tesanoff/midibayan/(threads)

Thread 1 (2024-10-23):

Работа отдельных фрагментов кода

Alexandr010360, 2024-10-23:
Здравствуйте Александр! Меня очень заинтересовал ваш проект! Особенно структура кода! Всё упорядочено, по полочкам и системно! Хотел позаимствовать у вас управление клавиатурой через сдвиговые регистры 74HC165. Даже сделал макет фрагмента кода из трёх кнопок. Но к сожалению он не заработал. Вы не смогли бы набросать мне фрагмент кода касающийся клавиатуры, который бы работал автономно и передавал миди команды.

tesanoff, 2024-10-23:
Добрый день.
к 6-й ноге ардуинки подключен каскад, читающий левую клавиатуру. [здесь задан этот пин](https://github.com/tesanoff/midibayan/blob/211e6babf87a316b51ede85d33aca2efe7c3e462/tes_midi_bayan/TesKeyboard.cpp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)

Смотрите как читается левая клавиатура.

В интернете очень много информации о том, как читать данные из сдвиговых регистров. (Если проблема именно с чтением данных из регистров). Соберите простейшую схему на макетке и тренируйтесь, как я делал: https://tesanoff.klah.ru/?p=5414

Alexandr010360, 2024-10-23:
Благодарю Александр! Теперь увидел замок! Буду пробовать! А что касается простейшего макета работы с регистрами то у меня это всё работает.

tesanoff, 2024-10-23:
Класс TesKeyboard читает данные с регистров, смотрит какие "музыкальные" кнопки были нажаты (или отпущены) и на основании этой информации помещает во внутреннюю очередь сообщений сообщения о соответствующих событиях. Только этот класс знает, что есть 2 каскада регистров, и т.д.

Класс TesMIDIController получает эти сообщения из внутренней очереди и обрабатывает (посылает соответствующие миди команды.) Миди-контроллер не знает ничего о деталях реализации чтения клавиатуры.

Alexandr010360, 2024-10-23:
На портe Ардуино D6 указан сигнал Kbd-DATA2 и есть разъём J6. Но на остальных схемах я не нащёл этого сигнала замка! Откуда он поступает?

Alexandr010360, 2024-10-23:
На схеме левой клавиатуры есть разъём J1 и на нём сигнал data-out. Это он?

tesanoff, 2024-10-23:
> На схеме левой клавиатуры есть разъём J1 и на нём сигнал data-out. Это он?

Так точно

tesanoff, 2024-10-23:
И ещё момент: эта прошивка не заработает нормально, если не подключен экранчик. Зависнет на этапе инициализации экранчика.

Alexandr010360, 2024-10-25:
Тема закрыта!

Alexandr010360, 2024-10-27:
Собрал макет из двух регистров сдвига и шести кнопок! Подаю питание, инициализация проходит нормально! Импульсы Latch и CLK присутствуют! Но только соит нажать одну из шести кнопок проскакивает один импульс Kbd-DATA и ардуинка намертво зависает! Latch и CLK пропадают! Сбрасываю её кнопкой сброса на плате и повторяется тоже самое! Отключаю от ардуинки входы Kbd-DATA  и она начинает работать нормально! Kbd-DATA на 9 ножках регистров при нажатии любой из кнопок имеются! Но стоит их подсоединить к ардуинке то она перестаёт работать!

Alexandr010360, 2024-10-27:
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

Alexandr010360, 2024-10-27:
Фто макета прилагаю...

tesanoff, 2024-10-27:
Извините, я с вашей бедой вам помочь не могу.
Могу только пожелать успехов в поиске причины такого поведения вашего макета.

Alexandr010360, 2024-10-27:
Спасибо Александр! Уже разобрался! Я брал по одному регистру на левую и правую клавиатуру! В этом случае сигнал переноса на 10 выводе регистра должен быть притянут к питанию! А я этого не сделал! А при каскадном включении нескольких регистров сигнал переноса приходит с предыдущего регистра!

Alexandr010360, 2024-10-27:
Uploading WhatsApp Video 2024-10-27 at 19.11.52.mp4…

Alexandr010360, 2024-10-27:
Uploading WhatsApp Video 2024-10-27 at 19.11.52.mp4…

Alexandr010360, 2024-10-27:
https://github.com/user-attachments/assets/d49b1244-3ceb-4390-b175-83d8c6913b7b

Alexandr010360, 2024-10-27:
Вот результат! Тему закрываю!

tesanoff, 2024-10-27:
Ишь ты.
Даже какие-то звуки издаёт. :)

Alexandr010360, 2024-10-27:
Это у меня работает через виртуальный мост Hairless MIDI<->Serial Bridge! А с него уже идёт на программный секвенсор...

tesanoff, 2024-10-28:
Кстати, я обратил внимание, что есть очень заметная задержка между щелчком кнопки и звуком инструмента.

Видимо это из-за не самого быстродействующего софта.

Я подключался к VMPK (на Линуксе) https://sourceforge.net/projects/vmpk/
Вообще никаких задержек не слышно.

tesanoff, 2024-10-28:
Адаптация для гармони делается здесь: https://gitflic.ru/project/tesanoff/midi-garmon
Еще не готово.
Точнее говоря, схемы уже нарисованы, платы заказаны и едут к хозяину гармони. Проверки на реальном железе пока не было. Когда будет готово - сделаю релиз на Gitflic и возможно сделаю зеркало на github.

Alexandr010360, 2024-10-28:
Благодарю за ваш огромный труд! Пытался сам адаптировать прошивку под гармонь! Но как говорят чужая прошивка для меня пока тёмный лес! Долго нужно изучать что к чему!

Alexandr010360, 2024-10-28:
Я тоже сейчас скачал и подключал  VMPK. Задержка стала меньше! Дело в драйвере звуковой карты. Тем более подключение не через миди кабель а по UART. Для опытов нормально. А потом можно подключиться по стандартному протоколу через миди кабель к внешней звуковой карте. Там задержки вообще незаметны на слух!

tesanoff, 2024-10-28:
Да, в windows не самая быстрая MIDI поддержка...

Alexandr010360, 2024-10-29:
Добрый день Александр! Читал ваш блог и планы на будущее! Желаю вам успеха! Планы поистине грандиозные! Идея с SD-картой мне понравилась! Вот бы можно было с карты проигрывать стили автоаккомпанимента а не только жёстко запрограммированный ритм! Так же можно было бы гибко менять и конфигурацию оборудования. Назначать функции клавиш и кнопок управления. Назначать горячие клавиши чтобы менять на ходу во время исполнения песни разные эффекты, тембры, стили автоаккомпанимента! У меня есть исходники по этой теме. Могу поделиться! Зачем велосипед изобретать заново, когда его уже изобрели... Куда вам отправить файлы?

Alexandr010360, 2024-10-29:
`/*
    BLE_MIDI_HARMONICA
*/

#include <BLEDevice.h>
#include <BLEUtils.h>
#include <BLEServer.h>
#include <BLE2902.h>
#include "notes.h"
#include "keyboards.h"

#define CHANNEL0 0
#define CHANNEL1 1
#define CHANNEL2 2

#define SERVICE_UUID        "03b80e5a-ede8-4b33-a751-6ce34ec4c700"
#define CHARACTERISTIC_UUID "7772e5db-3868-4112-a1a9-f2669d106bf3"

const byte LATCH = 25;
const byte DATA  = 26;
const byte CLOCK = 14;

BLECharacteristic *pCharacteristic;
bool deviceConnected = false;

class MyServerCallbacks: public BLEServerCallbacks {
    void onConnect(BLEServer* pServer) {
      deviceConnected = true;
    };

    void onDisconnect(BLEServer* pServer) {
      deviceConnected = false;
    }
};

void setupBle() {
  BLEDevice::init("MIDI HARMONICA");
  BLEServer *pServer = BLEDevice::createServer();
  pServer->setCallbacks(new MyServerCallbacks());
  BLEService *pService = pServer->createService(BLEUUID(SERVICE_UUID));
  pCharacteristic = pService->createCharacteristic(
                      BLEUUID(CHARACTERISTIC_UUID),
                      BLECharacteristic::PROPERTY_READ   |
                      BLECharacteristic::PROPERTY_WRITE  |
                      BLECharacteristic::PROPERTY_NOTIFY |
                      BLECharacteristic::PROPERTY_WRITE_NR
                    );
  pCharacteristic->addDescriptor(new BLE2902());
  pService->start();
  BLEAdvertising *pAdvertising = pServer->getAdvertising();
  pAdvertising->addServiceUUID(pService->getUUID());
  pAdvertising->start();
}

void setupKeyboard() {
  pinMode(LATCH, OUTPUT);
  pinMode(CLOCK, OUTPUT);
  pinMode(DATA, INPUT);
  digitalWrite(LATCH, HIGH);
}

uint64_t readKeyboard() {
  digitalWrite(LATCH, LOW);
  digitalWrite(LATCH, HIGH);

  byte buffer[8];
  for ( int i = 0; i < 8; i++) {
    buffer[i] = shiftIn(DATA, CLOCK, MSBFIRST);
  }

  uint64_t states = 0;
  for ( int i = 7; i >= 0; i--) {
    states <<= 8;
    states |= (uint64_t) buffer[i];
  }
  return states;
}

void noteOn(BLECharacteristic *midiDevice, uint8_t note, uint8_t channel) {
  uint8_t channels[3] = { 0x90, 0x91, 0x92 };
  uint8_t midiPacket[] = {
    0x80,               // header
    0x80,               // timestamp, not implemented
    channels[channel],  // action
    note,               // pitch
    127                 // velocity
  };
  midiPacket[2] = channels[channel];    // note down, channel 0
  midiPacket[3] = note;                 // note
  midiPacket[4] = 127;                  // velocity
  midiDevice->setValue(midiPacket, 5);  // packet, length in bytes
  midiDevice->notify();
}

void noteOff(BLECharacteristic *midiDevice, uint8_t note, uint8_t channel) {
  uint8_t channels[3] = { 0x80, 0x81, 0x82 };
  uint8_t midiPacket[] = {
    0x80,               // header
    0x80,               // timestamp, not implemented
    channels[channel],  // action
    note,               // pitch
    0                   // velocity
  };
  midiDevice->setValue(midiPacket, 5);  // packet, length in bytes
  midiDevice->notify();
}

void processKeyboardChanges(uint64_t keyboard) {
  static uint64_t last_keyboard = 0;
  if (keyboard == last_keyboard) {
    return;
  }
  uint64_t changed = keyboard ^ last_keyboard;
  last_keyboard = keyboard;
  for (int i = 0; i <= 64; ++i)
  {
    if (changed & 1) {
      handleChange(i, keyboard & 1);
    }
    changed >>= 1;
    keyboard >>= 1;
  }
}

void handleChange(int key, int state) {
  uint8_t note = 0;
  uint8_t channel = 0;
  if (key < sizeof(rightKeyboard)) {
    note = rightKeyboard[key];
    channel = CHANNEL0;
  } else if (key >= 32 && key < (32 + sizeof(bassKeyboard))) {
    note = bassKeyboard[key - 32];
    channel = CHANNEL1;
  } else if (key >= 32 + sizeof(bassKeyboard)) {
    note = accordKeyboard[key - 32 - sizeof(bassKeyboard)];
    channel = CHANNEL2;
  } else {
    return;
  }
  if (state) {
    Serial.print("noteOn -> ");
    Serial.println(note);
    Serial.print("channel -> ");
    Serial.println(channel);
    Serial.println("");
    noteOn(pCharacteristic, note, channel);
  } else {
    Serial.print("noteOff -> ");
    Serial.println(note);
    Serial.print("channel -> ");
    Serial.println(channel);
    Serial.println("");
    noteOff(pCharacteristic, note, channel);
  }
}

void setup() {
  Serial.begin(115200);
  setupKeyboard();
  setupBle();
}

void loop() {
  if (deviceConnected) {
    uint64_t keyboard = readKeyboard();
    processKeyboardChanges(keyboard);
  }
}
`

tesanoff, 2024-10-29:
>  У меня есть исходники по этой теме. Могу поделиться!

спасибо, ничего не надо :)

Alexandr010360, 2024-10-29:
Всё понял! Извините!

tesanoff, 2024-10-29:
не за что извиняться, что вы.

Просто я в чужой код стараюсь вообще не лазить, если нет острой необходимости. Применительно к чтению миди-файлов такая необходимость есть (писать своё будет заметно дольше, чем адаптировать чужое), но я уже нашёл шикарный исходник. (см блог)

Alexandr010360, 2024-10-29:
Хотел бы иногда по возможности обращаться к вам за помощью в некоторых критических ситуациях! Дело в том что я уже два года использую миди библиотеку адаптированную в универсальную панель управления DAW. Эта библиотека имеет возможность расширения и добавление в неё новых функций! Но к сожалению автором уже не поддерживается! Я её переделал под свои нужды и сделал миди гармонь Беларусь. Но там есть не решёные ньюансы. Один из них это отстсутствие поддержки регистров сдвига! Пришлось всё делать на матрицах. И второй ньюанс это отображение на дисплее не названий программ, а их номеров в миди системе, как и в вашем коде! Ну это ладно, как то можно смириться! Но вот во второй версии моей гармони, предназначеной к совместной работе с DAW vAranger это недопустимо! В этом проекте кнопки панели управления программно привязаны к параметрам DAW. И я должен видеть полное отображение на дисплее этих параметров, когда я нажимаю одну из кнопок панели управления! А их 30 штук! Цифры тут никак не уместны! А параметры настроек и управление DAW вот они: 1 TRANSPOSE -
  2 TRANSPOSE +
  3 PREV S0NG
  4 NEXT SONG
  5 TEMPO -
  6 TEMPO +
  7 MANUAL BASS
  8 BASS TO LOWEST
  9 SECUND BOICE
  10 FULL KEYBOARD
  11 MY S0UND RIGHT 1
  12 MY S0UND RIGHT 2
  13 MY S0UND RIGHT 3
  14 MY S0UND RIGHT 4
  15 MY S0UND RIGHT 5
  16 MY SOUND LEFT 1
  17 MY SOUND LEFT 2
  18 MY SOUND LEFT 3
  19 MY SOUND LEFT 4
  20 MY SOUND LEFT 5
  21 START/STOP
  22 SYNG START
  23 INTRO 1
  24 INTRO 2
  25 INTRO 3
  26 ENDING 1
  27 ENDING 2
  28 ENDING 3
  29 VARIATION DOWN
  30 VARIATION UP

tesanoff, 2024-10-29:
а в чем сам вопрос?

Alexandr010360, 2024-10-29:
Матрицы заменить на регистры сдвига и параметры кнопок управления отобразить на дисплее! Вот и ломаю голову как это сделать...

Alexandr010360, 2024-10-29:
Это нужно ворошить библиотеку или просто в код добавить коассы дисплея и регистров сдвига...

Alexandr010360, 2024-10-29:
Знаний в программировании недостаточно...

tesanoff, 2024-10-29:
> Матрицы заменить на регистры сдвига

Если честно, не понял.

"Регистр сдвига" - это микросхемы которые, например, я использовал для ввода кнопок и вывода на светодиоды 74HC165 и 74HC595.
А "матрица" - это что?

Alexandr010360, 2024-10-29:
Матричная клавиатура как на первом баяне Александра Поликарпова...

tesanoff, 2024-10-29:
а-а-а. Понял.
Замену этой системы ввода на ввод через регистры я уже сделал. :)

Читайте здесь: https://github.com/tesanoff/midibayan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

Alexandr010360, 2024-10-29:
Так вот по этой причине меня и заинтересовал ваш собственный проект! А вот как это прикрутить к моему коду пока ломаю голову!

Alexandr010360, 2024-10-29:
Для проекта гармони все порты Ардуино Мега почти заняты! А для баяна вообще уже не хватает портов! Применение в моём проекте регистров сдвига решило бы проблему...

Alexandr010360, 2024-10-29:
Сделать какой нибудь отдельный класс с регистрами сдвига и прилепить его к моему коду! Пока не знаю как это сделать!

tesanoff, 2024-10-29:
Ну, берите мою прошивку и дорабатывайте под свои нужды. Я никаких ограничений на эту тему не накладываю.

Возможно, вам стоит взять в соавторы программиста, квалификации которого будет достаточно, чтобы разобраться в коде и придумать, что и как надо менять. (Я не возьмусь, если что).

Alexandr010360, 2024-10-29:
Вот я и изучаю вашу прошивку! Так то конечно разберусь и без программистов только это будет долгий процесс...
Буду следить за вашими новыми публикациями! Очень интересные у вас идеи! Бутусову и не снились такие идеи со стилями для автоаккомпанимента!

Alexandr010360, 2024-10-30:
Как сделать чтобы нажатие одной из множества кнопок на дисплее отображалось её название одной строчкой? В интернете что то не нашёл такой пример кода...

tesanoff, 2024-10-30:
Если по-нормальному, то надо добавлять ещё один вариант экрана:
* идентификатор статуса экрана
* функция для отрисовки экрана
* функция для обработки нажатий клавиш в этом режиме
* посмотреть не возникает ли нежелательных побочных эффектов

Если для отладки, то:
* чистим экран вызывая функцию clear() если правильно помню
* печатаем на экране всё что надо
* выводим буфера на экран функцией update()
* Даём задержку на пару-тройку секунд, чтобы успеть это прочитать

Alexandr010360, 2024-10-30:
Спасибо Александр за инструкцию! Буду пробовать...

Closed 2024-10-27.

Thread 2 (2024-10-24):

Смена дисплея на SSD1306_128x64

Alexandr010360, 2024-10-24:
Добрый день Александр! У меня в наличии дисплей SSD1306_128x64. В скетче меняю SSH1106_128x64 на SSD1306_128x64! Но компилятор начинает ругаться! Помогите пожалуйста разобраться в проблеме...

Alexandr010360, 2024-10-24:
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

Alexandr010360, 2024-10-24:
Вот такие крякозябры с моим дисплеем!

tesanoff, 2024-10-24:
Документацию на библиотеку изучали? https://github.com/GyverLibs/GyverOLED
(Особенно разделы "Инициализация" и "Использование")

Работу примеров (https://github.com/GyverLibs/GyverOLED/tree/main/examples) на вашем экране проверяли?

Alexandr010360, 2024-10-24:
Примеры все работают нормально! Использовал эту библиотеку в других своих проектах. Там всё отлично работает.

Alexandr010360, 2024-10-24:
Ядро я не менял. Может быть в этом дело? И вообще с кнопками работает очень не стабильно. С холлами не пробовал.

Alexandr010360, 2024-10-24:
Попробую сейчас ядро поменять...

tesanoff, 2024-10-24:
Проверяйте, во всех ли местах используется правильная инициализация класса дисплея.
В прошивке несколько таких мест.
Используйте команду "grep GyverOLED *"

tesanoff, 2024-10-24:
> И вообще с кнопками работает очень не стабильно.

Если это макетка, то:
1) контакты
2) висящие в воздухе входы регистров

Alexandr010360, 2024-10-24:
Все места посмотрел! И менял на другой дисплей. свободные входы регистров заземлил...

Alexandr010360, 2024-10-24:
А у вас нет такой возможности проверить с другим дисплеем ваш код?

Alexandr010360, 2024-10-24:
Придётся тогда купить дисплей SSH1106_128x64...

tesanoff, 2024-10-24:
Ну, чудес не бывает.
Ищите разницу между тем, что сейчас в прошивке, и тем, что в работающих примерах.
Покажите пример того, как вы инициализируете класс. Прям кусок вашего кода.

Alexandr010360, 2024-10-24:
Там не кусок кода. Я загрузил полностью вашу прошивку...

tesanoff, 2024-10-24:
> Там не кусок кода. Я загрузил полностью вашу прошивку...

Тип дисплея не меняли? Неудивительно что не работает.

Если меняли, то покажите измененный участок кода :)

Alexandr010360, 2024-10-24:
GyverOLED<SSH1106_128x64> oled; Все эти места менял...

Alexandr010360, 2024-10-24:
Может текст ошибки вам отправить?

Alexandr010360, 2024-10-24:
GyverOLED<SSD1306_128x64, OLED_NO_BUFFER> oled; Если только ещё так попробовать?

Alexandr010360, 2024-10-24:
В примерах если раскомментировать вот это GyverOLED<SSH1106_128x64> oled; То так же вылезают крякозябры как и в вашей прошивке...

tesanoff, 2024-10-24:
> GyverOLED<SSH1106_128x64> oled; Все эти места менял...

именно такие места надо было менять.
Покажите ваш вариант кода который получился после того, как вы поменяли тип дисплея.

Alexandr010360, 2024-10-24:
А если раскомментировать вот это GyverOLED<SSD1306_128x64, OLED_NO_BUFFER> oled; То дисплей работает нормально...

Alexandr010360, 2024-10-24:
Дело в том что в библиотеке и настраивать то нечего! А делаю как в примерах не работает!

Alexandr010360, 2024-10-24:
Я имею ввиду с вашим кодом...

Alexandr010360, 2024-10-24:
Не получается самому разобраться в вашей прошивке! Это автор только может...

Alexandr010360, 2024-10-24:
Буду дальше изучать код! Может что ещё увижу...

Alexandr010360, 2024-10-24:
Может ядро как то влияет?

Alexandr010360, 2024-10-24:
Да ладно! На Озоне есть такие дисплеи как ваш. Закажу и вопрос закрыт...

tesanoff, 2024-10-24:
> А если раскомментировать вот это GyverOLED<SSD1306_128x64, OLED_NO_BUFFER> oled; То дисплей работает нормально...

Так всё-таки работает дисплей или не работает?

В любом случае мне надо видеть код с вашим вариантом инициализации дисплея. Я не могу вслепую комментировать.
Пожалуйста, покажите тот код инициализации дисплея, который у вас сейчас.
И скажите, работает дисплей с таким вариантом инициализации или нет.

Жду кода.

Alexandr010360, 2024-10-24:
В примерах библиотеки работает а в вашем коде нет. Буду искать в чём причина...

Alexandr010360, 2024-10-24:
Собственно код ваш без изменения! Менял только это во всех файлах кода где он есть GyverOLED<SSD1306_128x64, OLED_NO_BUFFER> oled;

tesanoff, 2024-10-24:
> Собственно код ваш без изменения! Менял только это во всех файлах кода где он есть GyverOLED<SSD1306_128x64, OLED_NO_BUFFER> oled;

И в результате заработало или нет?

(Вообще, лучше выбрать вариант с буфером.)

Alexandr010360, 2024-10-24:
// OLED-дисплей
GyverOLED<SSD1306_128x64, OLED_NO_BUFFER> oled;

// MIDI-контроллер
TesMIDIController   theMIDIController(&ledSet, &oled); - ругается на это!

tesanoff, 2024-10-24:
> TesMIDIController theMIDIController(&ledSet, &oled); - ругается на это!

Правильно, потому что менять нужно везде, где встречается строка "GyverOLED<", а не только в одном месте.
Это же темплейтный класс.

Alexandr010360, 2024-10-24:
Вот я и менял везде! Сейчас по ходу покажу...

                                                     ^

Alexandr010360, 2024-10-24:
Теперь на это ругается // Конструктор
TesMIDIController::TesMIDIController(TesLedSet *led_panel, GyverOLED<SSD1306_128x64, OLED_NO_BUFFER> *oled)
    :_ui(oled, this, led_panel),
    _auto_drums(&_midi_queue)

Alexandr010360, 2024-10-24:
Ещё раз проверю и напишу что получилось...

tesanoff, 2024-10-24:
Везде (вообще везде) где встречается такая строчка:
`GyverOLED<SSH1106_128x64>`

её надо заменить на такую:
`GyverOLED<SSD1306_128x64, OLED_BUFFER>`

Вообще везде, даже если вам кажется что в каком-то конкретном месте менять не надо.

И должно скомпилиться и заработать.

Alexandr010360, 2024-10-24:
Везде поменял а потом стал компилировать! Вроде грузится! Я неправильно делал! Одну заменю компилирую. Потом дальше. Следующую. А нужно было всё заменить а потом компилировать! Но инициализация дисплея не прошла! Потому что я его вытащил! Сейчас поставлю на место и скомпилирую...

Alexandr010360, 2024-10-24:
![Uploading 0644e846-c2b2-4ef0-a965-4b8295ae16d8.jpg…]()

tesanoff, 2024-10-24:
Отлично!

Alexandr010360, 2024-10-24:
Теперь буду пробовать с датчиками холла! Кнопки глючат!

tesanoff, 2024-10-24:
> Кнопки глючат!

Вообще, не должно быть никакой разницы между кнопками и датчиками. Я на таких же кнопках отлаживался, как у вас: https://rutube.ru/video/8d49a0cc3f9e7e1af202a5c735093099/?r=wd

Alexandr010360, 2024-10-24:
Очень странные глюки идут по тактовому сигналу на выводе 2 регистра! Пока держишь на нём щуп осциллографа тактовая частота есть. Как только убрал и через некоторое время она пропадает. Нажимаю кнопку сброса на Ардуино и она появляется, потом обратно пропадает. Так же импульс защёлки пропадает вместе с частотой!

Alexandr010360, 2024-10-24:
На Меге у меня так никогда не было!

Alexandr010360, 2024-10-24:
Завтра буду пробовать на Ардуино UNO...

Alexandr010360, 2024-10-25:
По дисплею тему закрываю! А что касается неустойчивой работы Ардуино Нано будет другая тема.

Alexandr010360, 2024-10-25:
Тема по дисплею закрыта.

Closed 2024-10-25.

Thread 3 (2024-10-25):

Замена ядра Ардуино Нано с целью оптимизации ресурсов микроконтролера

Alexandr010360, 2024-10-25:
Пытался заменить ядро следуя инструкции. Но к сожалению ничего не получилось. В окне Ардуино IDE пишет что нет такого протокола! Буду пытаться ставить ядро другими методами.

Alexandr010360, 2024-10-25:
Что в этой ссылке не так? https://alexgyver.github.io/package_GyverCore_index.json

Alexandr010360, 2024-10-25:
Что в этой ссылке не так? https://alexgyver.github.io/package_GyverCore_index.json

Alexandr010360, 2024-10-25:
Все методы испытал! Ничего не получилось!

tesanoff, 2024-10-25:
Ну, я не самый большой специалист по Adruino IDE.
К тому же я не под Windows работаю, а под Linux.
В принципе можно и без ядра, просто свободной памяти заметно меньше останется и код будет немного медленнее работать.

Alexandr010360, 2024-10-25:
Вопрос о ядре я поднял только потому что при компиляции прошивки выскакивает предупреждение недостаточно памяти! И что из-за этого возможно нестабильная работа прошивки. Хотел заменить ядро чтобы освободить ещё немного памяти. Может поэтому у меня глючит Ардуино Ноно? Что интересно она глючила и с первой прошивкой Александра Поликарпова! У него тоже вся память была забита! Поэтому и хочу разобраться в причине глюков методом экспериментов. А кнопки тут не причём, я выяснил. Пропадают сигналы Kbd-CLK и Kbd-Latch. Может быть потому что подключена только часть схемы на макете! А делать сразу на готовых платах это риск и лишние затраты! Хотелось бы убедиться в работоспособности и стабильности макета. Мои собственные проекты на макете работают стабильно. У меня все входы и выходы фильтруются программно! А на регистрах сдвига такую фильтрацию не применишь...

Alexandr010360, 2024-10-25:
Собственно вопрос в том что я не хочу применять матричную систему клавиатуры как в моих проектах по причине потребления датчиками холла тока опасного для портов Ардуино! Паспортный максимальный ток одного вывода 40 миллиампер! А одновременно открытые к примеру 8 датчиков холла уже перегружают порт Ардуино!

Alexandr010360, 2024-10-25:
Ладно, спасибо что откликнулись на мой запрос! Надеюсь разберусь. Тему закрываю...

tesanoff, 2024-10-25:
> Вопрос о ядре я поднял только потому что при компиляции прошивки выскакивает предупреждение недостаточно памяти!

У меня тоже выскакивает. Это нормально и ожидаемо. если есть хотя бы 150 байт свободных - должнго работать нормально, я стек не сильно нагружаю.

>  А делать сразу на готовых платах это риск и лишние затраты!

Что мешает сделать макет на 1 или 2 регистра и отладочный вариант прошивки?
Я весь баян написал и отладил используя только 6 кнопок. :)

Alexandr010360, 2024-10-25:
Буду разбираться почему пропадают тактовые сигналы с Ардуино Нано...

tesanoff, 2024-10-25:
заменить ее и всё
она стоит не так много

tesanoff, 2024-10-25:
Или другой пин использовать

Alexandr010360, 2024-10-25:
Вот я и попробую её заменить. А пока она идёт по заказу испытаю этот макет с Ардуино UNO...

Alexandr010360, 2024-10-25:
Переустановил программу Arduino IDE и загрузил новое ядро! Экономия памяти значительная! Оперативки осталось ещё 1163 байта! Но глюки так и остались! Буду менять Ардуину!

Closed 2024-10-25.
