tesanoff/midibayan/(list of files, drawings)

Other design files:
boards/obsolete/PCB_Right_keyboard_back.json
boards/obsolete/PCB_Right_keyboard_front.json
boards/obsolete/SCH_Right_keyboard_back.json
boards/obsolete/SCH_Right_keyboard_front.json
boards/PCB_Control_panel.json
boards/PCB_Left_keyboard.json
boards/PCB_main.json
boards/PCB_Right_kbd_Back_1.json
boards/PCB_Right_kbd_Back_2.json
boards/PCB_Right_kbd_Front_1.json
boards/PCB_Right_kbd_Front_2.json
boards/SCH_Control_panel.json
boards/SCH_Left_keyboard.json
boards/SCH_main.json
boards/SCH_Right_kbd_Back_1.json
boards/SCH_Right_kbd_Back_2.json
boards/SCH_Right_kbd_Front_1.json
boards/SCH_Right_kbd_Front_2.json
