tesanoff/midibayan/tes_midi_bayan/midi_note_names.h

///////////////////////////////////////////////////////////////////
// Defines a lot of MIDI notes.
// This list is too long to be included directly into the sketch.

#ifndef _MIDI_NOTE_NAMES
#define _MIDI_NOTE_NAMES


// Sub-Contr. octave
#define _C0  0x0C
#define _Db0 0x0D
#define _D0  0x0E
#define _Eb0 0x0F
#define _E0  0x10
#define _F0  0x11
#define _Gb0 0x12
#define _G0  0x13
#define _Ab0 0x14
#define _A0  0x15
#define _Bb0 0x16
#define _B0  0x17
// Contr. octave
#define _C1  0x18
#define _Db1 0x19
#define _D1  0x1A
#define _Eb1 0x1B
#define _E1  0x1C
#define _F1  0x1D   // <-- Lowest note in the Left keyboard
#define _Gb1 0x1E
#define _G1  0x1F
#define _Ab1 0x20
#define _A1  0x21
#define _Bb1 0x22
#define _B1  0x23
// Big octave
#define _C2  0x24
#define _Db2 0x25
#define _D2  0x26
#define _Eb2 0x27
#define _E2  0x28
#define _F2  0x29
#define _Gb2 0x2A
#define _G2  0x2B
#define _Ab2 0x2C
#define _A2  0x2D
#define _Bb2 0x2E
#define _B2  0x2F
// Small octave
#define _C3  0x30
#define _Db3 0x31
#define _D3  0x32
#define _Eb3 0x33
#define _E3  0x34
#define _F3  0x35
#define _Gb3 0x36
#define _G3  0x37
#define _Ab3 0x38
#define _A3  0x39
#define _Bb3 0x3A
#define _B3  0x3B
// 1st octave
#define _C4  0x3C
#define _Db4 0x3D
#define _D4  0x3E
#define _Eb4 0x3F
#define _E4  0x40
#define _F4  0x41
#define _Gb4 0x42
#define _G4  0x43
#define _Ab4 0x44
#define _A4  0x45
#define _Bb4 0x46
#define _B4  0x47
// 2nd octave
#define _C5  0x48
#define _Db5 0x49
#define _D5  0x4A
#define _Eb5 0x4B
#define _E5  0x4C
#define _F5  0x4D
#define _Gb5 0x4E
#define _G5  0x4F
#define _Ab5 0x50
#define _A5  0x51
#define _Bb5 0x52
#define _B5  0x53
// 3rd octave
#define _C6  0x54
#define _Db6 0x55
#define _D6  0x56
#define _Eb6 0x57
#define _E6  0x58
#define _F6  0x59
#define _Gb6 0x5A
#define _G6  0x5B
#define _Ab6 0x5C
#define _A6  0x5D
#define _Bb6 0x5E
#define _B6  0x5F
// 4th octave
#define _C7  0x60
#define _Db7 0x61
#define _D7  0x62
#define _Eb7 0x63
#define _E7  0x64   // <-- Highest note in the Rignt keyboard
#define _F7  0x65
#define _Gb7 0x66
#define _G7  0x67
#define _Ab7 0x68
#define _A7  0x69
#define _Bb7 0x6A
#define _B7  0x6B
// 5th octave
#define _C8  0x6C
#define _Db8 0x6D
#define _D8  0x6E
#define _Eb8 0x6F
#define _E8  0x70
#define _F8  0x71
#define _Gb8 0x72
#define _G8  0x73
#define _Ab8 0x74
#define _A8  0x75
#define _Bb8 0x76
#define _B8  0x77

#endif
